aaroexxt/6.1820-NEPTUNE/Paper/resources/brainstorm.png

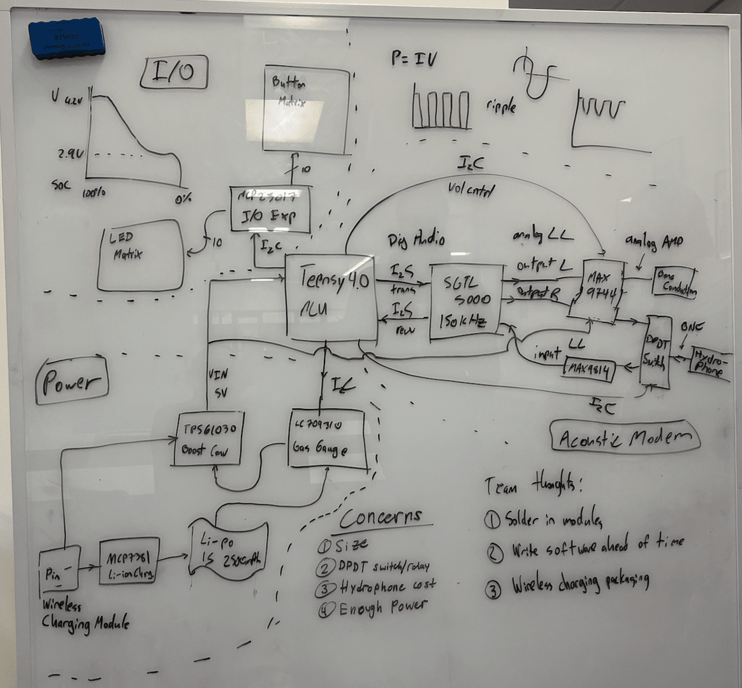
Paper/resources/brainstorm.png
