aaroexxt/6.1820-NEPTUNE/README.md

# 6.1820-NEPTUNE
6.1820 final project - Aaron Becker and Nora Bulovic
