aaroexxt/6.1820-NEPTUNE/Paper/NEPTUNE.tex

% !TEX encoding = UTF-8 Unicode
% !BIB TS-program = biber

% This file is NEPTUNE.tex, the LaTeX original source for Aaron Becker & Nora Bulovic's final project. It was based on MIT-Thesis.tex, a LaTeX template for formatting an MIT thesis with the mitthesis class.
%
% Version history:
% 0.1, 2025/3/14 - initial creation
% 0.2, 2025/3/19 - chapter organization
%
% Author: Aaron Becker & Nora Bulovic, copyright 2025. Released under the MIT license.
% Original template author: John H. Lienhard, copyright 2024. Reuse under the MIT license: https://ctan.org/license/mit 

% Documentation is here: https://ctan.org/pkg/mitthesis
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
  \newcolumntype{d}[1]{D{.}{.}{#1}}% use with dcolumn package. Note: dcolumns are set in math mode.
  % syntax: d{x.y} where x is max number of digits before decimal and y is max number after.
% Package for multipage table in Appendix B.
\usepackage{longtable}% typeset multi-page tables (https://ctan.org/pkg/longtable)
%\usepackage{tabularx}% adjustable-width columns in tabular (https://ctan.org/pkg/tabularx)
%% Package for improved typography
\usepackage{microtype}% typographic fine-tuning, used in sample thesis committee page, but also acting globally on the text 

%%%%%%%%%  Graphics path (to figure files)  %%%%%%%%%%%%%%%%%%%%%%%%%%%%%%%%
%% Can set graphicspath to point to specific directories containing figures (the current directory is searched automatically)
%% For instance, to search a subdirectory of the current directory called "figures" and a parallel directory called "art", set:
\graphicspath{ {resources}}
% \graphicspath{ {figures/} {../art/} }% For details see: https://latexref.xyz/dev/latex2e.html#g_t_005cgraphicspath

%%%%%%%%%  Representative set-up for biblatex  %%%%%%%%%%%%%%%%%%%%%%%%%%%%%

%% Numerical citations of references
\usepackage[style=ext-numeric-comp,giveninits=true,maxbibnames=10,sorting=none]{biblatex}

%% IEEE style citations and references
% \usepackage[style=ieee,maxbibnames=10,sorting=none]{biblatex}% style=ext-numeric-comp,articlein=false,giveninits=true
%	 \DefineBibliographyStrings{english}{url= \textsc{url} ,  }% replaces the IEEE default "[Online]. Available" by "URL"

%% author-year style citations and references 
%% use \parencite, not \cite, when you want "(Author, year)"
%% The sample files are not set up to include parentheses.
% \usepackage[style=authoryear, maxbibnames=10]{biblatex} 

\addbibresource{neptune-bibliography.bib}

%% to avoid split urls and stretched white space, you can set the bibliography ragged-right:
%\appto{\bibsetup}{\raggedright}

%% biblatex is very powerful, and you can customize most aspects the reference list and citations to suit your needs.
%%   documentation is here: https://ctan.org/pkg/biblatex
%%   cheat sheet is here:   https://tug.ctan.org/info/biblatex-cheatsheet/biblatex-cheatsheet.pdf

%% To ensure citations are set, run Latex --> biblatex/biber --> Latex again

%%%%%%%%%%%  Metadata  %%%%%%%%%%%%%%%%%%%%%%%%%%%%%%%%%%%%%%%%%%%%%%%%%%%%%%%

\hypersetup{%
	pdfsubject={NepTune: Inexpensive Underwater Node for Remote Sensing and Communication},
% 
	pdfkeywords={Massachusetts Institute of Technology, MIT, water, communication, ocean, radio frequency, RF, sensor node, underwater, Aaron Becker, Nora Bulovic},
	% Add keywords that will help search engines and libraries to find your work.
	% Includes the name[s] of the author[s] 
	% (If you used \DocumentMetadata at line 14, you can just put "\CopyrightAuthor," for the names.)
%
	pdfurl={},
	% If you have a url for the thesis, put it here. Otherwise delete this.
	% (MIT Libraries will put your thesis in DSPACE with a persistent url after you submit it.)
%	
	pdfcontactemail={aaron.becker@gmail.com},
	% You can put a [permanent] email address into the metadata, if you like.
	% Otherwise delete this.
%
	pdfauthortitle={},
	% If you have a title, you can include it here.
}

%%%%%%%%%%%%  Math operators %%%%%%%%%%%%%%%%%%%%%%%%%%%%%%%%%%%%%%%%%%%%%%%%%%%%

% These commands declare two math operators, \erf{..} and \erfc{..} using mathtools
% note: * form produces automatic delimiter scaling; optional argument sets size manually, e.g. [\bigg]
% See Table 1.1 in Chapter 1

\DeclareMathOperator{\Erf}{erf}
\DeclareMathOperator{\Erfc}{erfc}
\DeclarePairedDelimiterXPP\erf[1]{\Erf\mkern1mu}(){}{#1}% increase to 2mu with stix2 font
\DeclarePairedDelimiterXPP\erfc[1]{\Erfc\mkern1mu}(){}{#1}

%%%%%%%%%%%%%%  End preamble %%%%%%%%%%%%%%%%%%%%%%%%%%%%%%%%%%%%%%%%%%%%%%%%%%%%%%%%%%%%%%%%%%%%%
%%%%%%%%%%%%%%%%%%%%%%%%%%%%%%%%%%%%%%%%%%%%%%%%%%%%%%%%%%%%%%%%%%%%%%%%%%%%%%%%%%%%%%%%%%%%%%%%%%

\begin{document}
%%% edit the following commands to match your thesis %%%%%%%%%%

\title{NepTune: Inexpensive Underwater Node for Remote Sensing and Communication}

\Author{Aaron M. Becker}{Department of Mechanical Engineering}
\Author{Nora Bulovic}{Department of Computer Science}

% If there is more than one supervisor, use the \Supervisor command for each.
\Supervisor{Dr. Barbara Hughey}{Senior Lecturer}

% Usage: \DegreeDate{Month}{year}
% Valid degree months are February, May, June, or September
\DegreeDate{May}{2025}

% Date that final thesis is submitted to department
\ThesisDate{May 9, 2025}

%%%%%%  Choose whether to have a CREATIVE COMMONS License  %%%%%%%%%%%%%%%%%%%%%%%%%%%%%%%%%%%%%%
%
% If you are using a cc license, uncomment the following line and insert details of your cc license here.
%
\CClicense{CC BY-NC 4.0}{https://creativecommons.org/licenses/by-nc/4.0/}
%

%%%%%%%%%%%%%%%%%%%%%%%%%%%%%%%%%%%%%%%%%%%%%%%%%%%%%%%%%%%%%%%%%%%%%%%%%%%%%%%%%%%%%%%%%%%%%%%%%

%%% Make titlepage
\maketitle

%%% Frontmatter
 %%%%%%%%%%%%%%%%%%%%%%%%%%%%%%%%%%%

% This page is optional. Edit the file committee_members.tex 
%\include{committee_members}

% The abstract environment creates all the required headings and footers. 
% You only need to the text of the abstract in the file abstract.tex
\begin{abstract}
	\input{abstract.tex}% use \input rather than \include because we're inside an environment
\end{abstract}

\include{acknowledgments}

%\include{biography}% biography.tex (optional, see https://libraries.mit.edu/distinctive-collections/thesis-specs/#format)

%%% Table of contents and lists of stuff (delete unused lists, i.e., if no tables or figures) %%%%%

\tableofcontents
\listoffigures
\listoftables

%%% Chapters of thesis  %%%%%%%%%%%%%%%%%%%%%%%%%%%%%%%%%%%%%%%%%%%%%%%%%%%%%%%%%%%%%%%%%%%%%%%%%%%

%% If you want to use "double spacing", you should start here...

\include{chapter1}
%\include{chapter2}
% \include{chapter3}
% \include{chapter4}

%%% Appendicies of thesis  %%%%%%%%%%%%%%%%%%%%%%%%%%%%%%%%%%%%%%%%%%%%%%%%%%%%%%%%%%%%%%%%%%%%%%%%

\appendix
\include{appendixa}
\include{appendixb}

%%% Bibliography (biblatex)  %%%%%%%%%%%%%%%%%%%%%%%%%%%%%%%%%%%%%%%%%%%%%%%%%%%%%%%%%%%%%%%%%%%%%%

\defbibheading{bibintoc}{\chapter*{#1}\addcontentsline{toc}{backmatter}{\refname}} 
% this sets the title of contents name for bibliography to \refname (= References)
% change "backmatter" to "chapter" if you prefer a bold face entry in the table of contents

\printbibliography[title={\refname},heading=bibintoc]

% biblatex also supports chapter-by-chapter bibliography, https://tex.stackexchange.com/a/296502/119566
% see the biblatex manual, section 3.14.3

\end{document}
