aaroexxt/6.1820-NEPTUNE/Paper/resources/elecDiagram.png

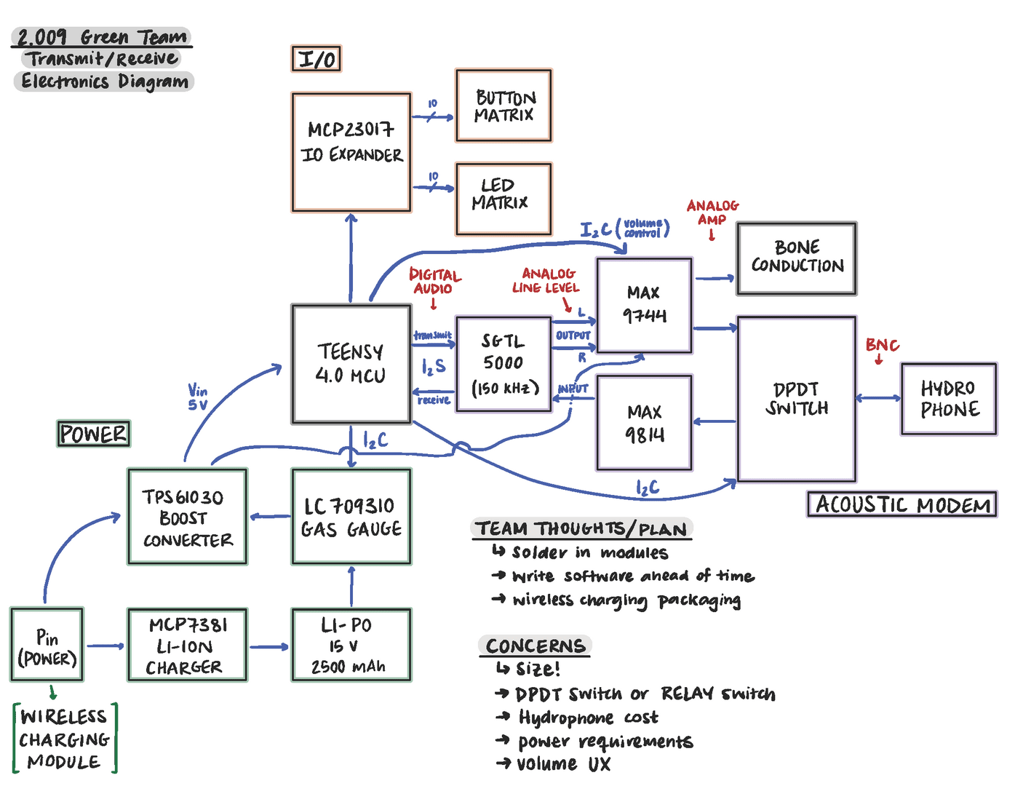
Paper/resources/elecDiagram.png
