aaroexxt/6.1820-NEPTUNE/Hardware - CAD/BottomCover.SLDPRT

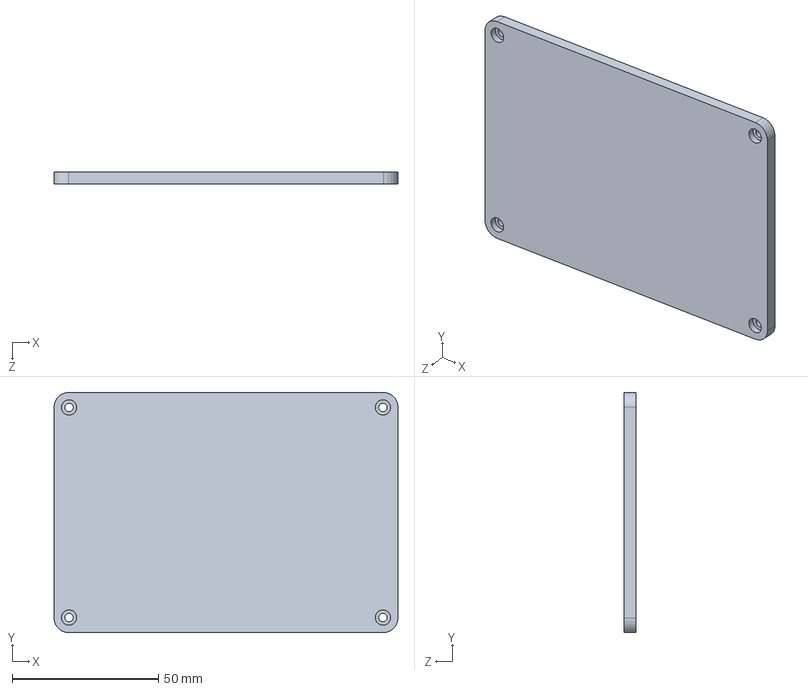
[picture p3: CAD file, 2025-05-01]
Hardware - CAD/BottomCover.SLDPRT
117.5 x 82.0 x 4.00 mm
