aaroexxt/6.1820-NEPTUNE/Hardware - Electronics/NeptuneV1/imports/Adafruit-MAX4466-SIMPLIFIED/Adafruit MAX4466 Mic Amp.dxf

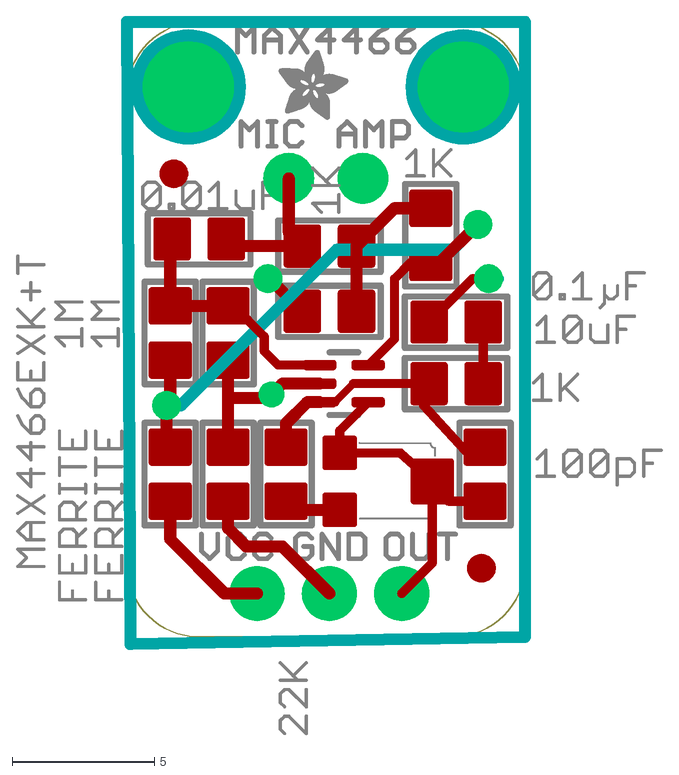
[picture p4: CAD file, 2025-04-03]
Hardware - Electronics/NeptuneV1/imports/Adafruit-MAX4466-SIMPLIFIED/Adafruit MAX4466 Mic Amp.dxf
22.7 x 25.2
