aaroexxt/6.1820-NEPTUNE/Hardware - Electronics/NeptuneV1/imports/Adafruit_BQ24074_Simplified.dxf

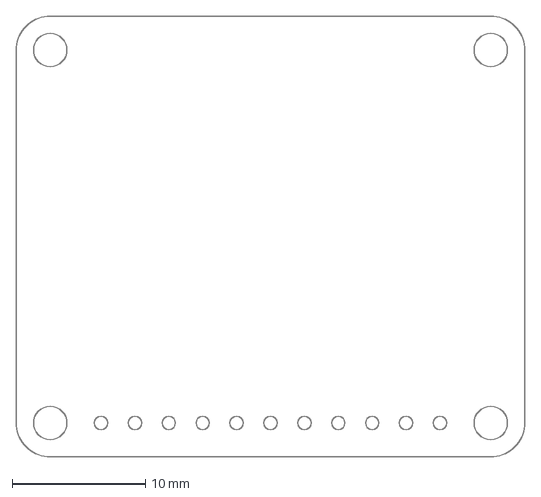
[picture p5: CAD file, 2025-04-03]
Hardware - Electronics/NeptuneV1/imports/Adafruit_BQ24074_Simplified.dxf
38.1 x 33.0 mm
