aaroexxt/6.1820-NEPTUNE/Hardware - CAD/TopCover.SLDPRT

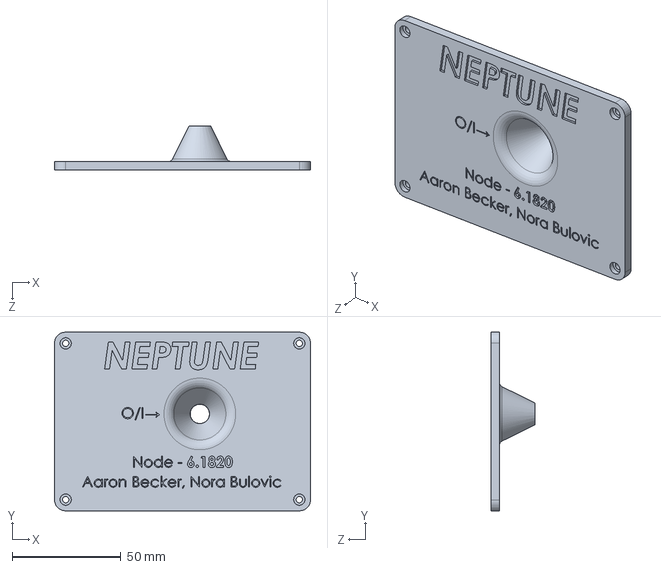
[picture p6: CAD file, 2025-05-01]
Hardware - CAD/TopCover.SLDPRT
117.5 x 82.0 x 20.3 mm
