aaroexxt/6.1820-NEPTUNE/Hardware - Electronics/NeptuneV1/imports/Adafruit_PB1K_Simplified.dxf

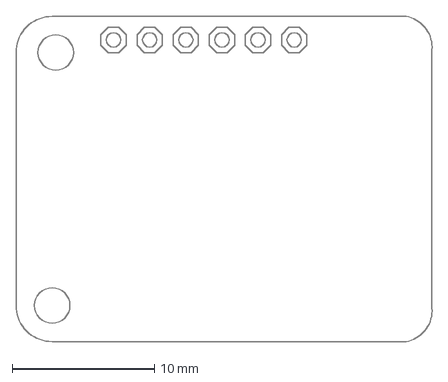
[picture p7: CAD file, 2025-04-03]
Hardware - Electronics/NeptuneV1/imports/Adafruit_PB1K_Simplified.dxf
29.2 x 22.9 mm
