aaroexxt/6.1820-NEPTUNE/Hardware - CAD/MiddlePlate.SLDPRT

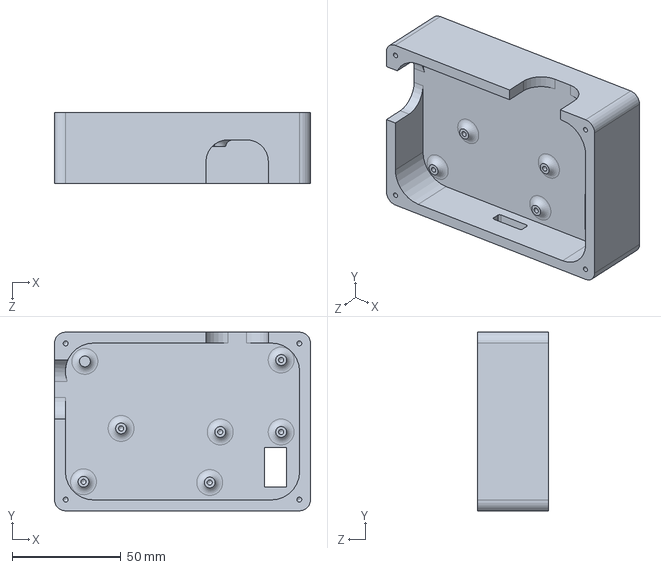
[picture p8: CAD file, 2025-04-18]
Hardware - CAD/MiddlePlate.SLDPRT
117.5 x 82.0 x 32.5 mm
