aaroexxt/6.1820-NEPTUNE/Hardware - Electronics/NeptuneV1/imports/Adafruit_TPA2016_Simplified.dxf

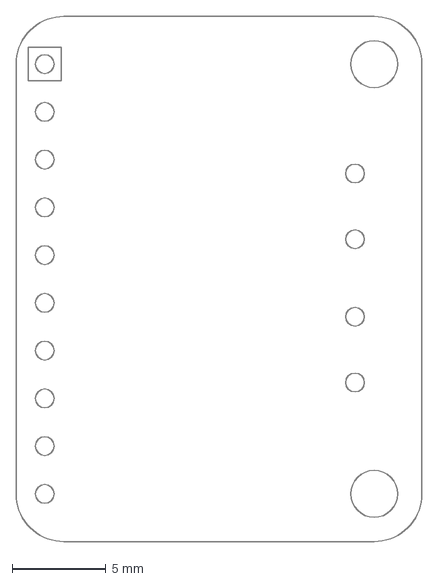
[picture p9: CAD file, 2025-04-03]
Hardware - Electronics/NeptuneV1/imports/Adafruit_TPA2016_Simplified.dxf
21.6 x 27.9 mm
