aaroexxt/6.1820-NEPTUNE/Hardware - Electronics/NeptuneV1/imports/Adafruit_MAX4466_Simplified.dxf

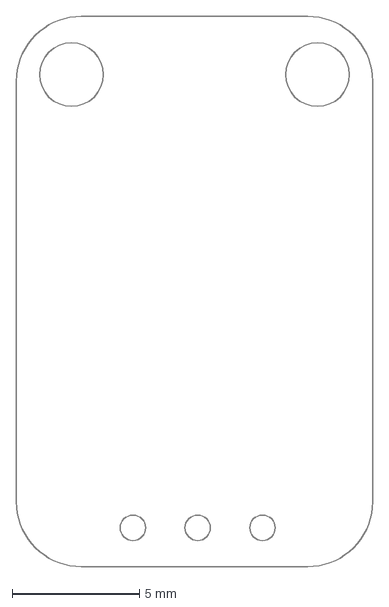
[picture p10: CAD file, 2025-04-03]
Hardware - Electronics/NeptuneV1/imports/Adafruit_MAX4466_Simplified.dxf
14.0 x 21.6 mm
