aaroexxt/6.1820-NEPTUNE/Hardware - CAD/EXT_258 1200mAh lipo.step

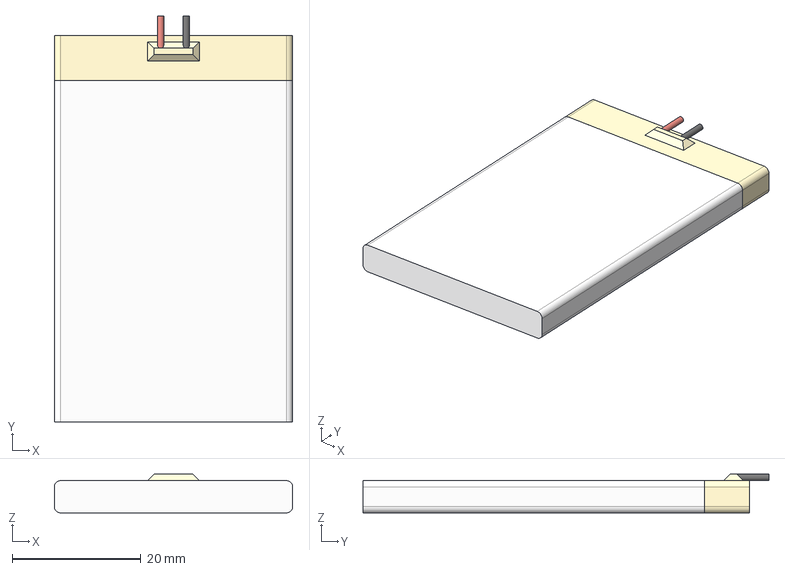
[picture p11: CAD file, 2025-04-10]
Hardware - CAD/EXT_258 1200mAh lipo.step
37.0 x 63.0 x 6.00 mm
