aaroexxt/6.1820-NEPTUNE/Hardware - CAD/EXT_94879A877_Off-White Nylon Phillips Rounded Head Screws.SLDPRT

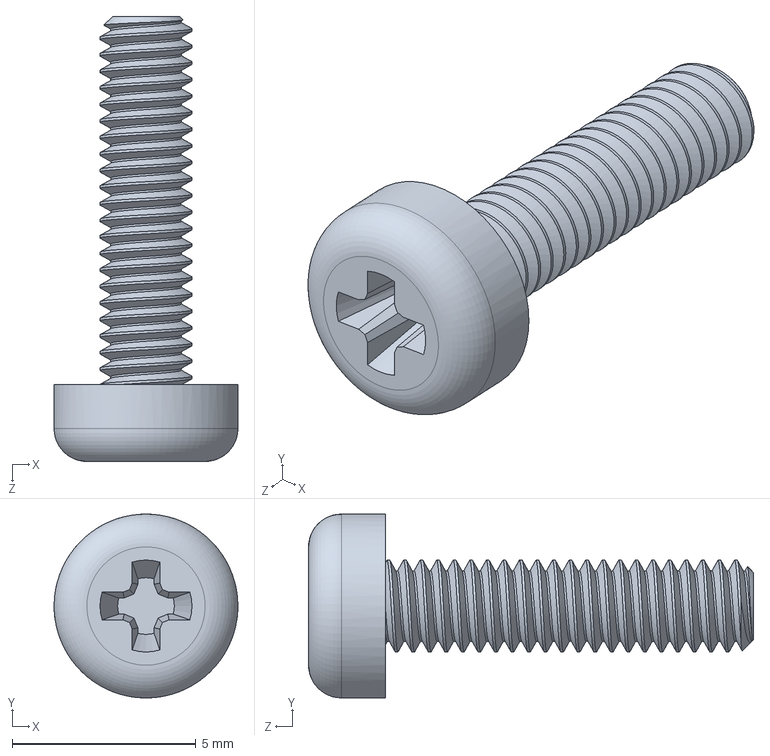
[picture p12: CAD file, 2025-04-18]
Hardware - CAD/EXT_94879A877_Off-White Nylon Phillips Rounded Head Screws.SLDPRT
5.00 x 5.00 x 12.1 mm
