aaroexxt/6.1820-NEPTUNE/(list of files, cad)

Other CAD files:
Hardware - CAD/BottomCover.STL
Hardware - CAD/EXT_258 1200mAh lipo.SLDPRT
Hardware - CAD/MiddlePlate.STL
Hardware - CAD/TopCover.STL
