aaroexxt/6.1820-NEPTUNE/Software - Embedded/test.txt

0.05 @ 4478.91Hz
0.08 @ 5986.23Hz
0.06 @ 4909.57Hz
0.08 @ 4909.57Hz
0.06 @ 5383.30Hz
0.05 @ 6029.30Hz
0.06 @ 5986.23Hz
0.06 @ 4608.10Hz
0.05 @ 4565.04Hz
0.06 @ 5383.30Hz
0.05 @ 4651.17Hz
0.06 @ 4565.04Hz
0.05 @ 5211.03Hz
0.05 @ 4478.91Hz
0.05 @ 5900.10Hz
0.06 @ 4521.97Hz
0.08 @ 4651.17Hz
0.05 @ 4651.17Hz
0.05 @ 5986.23Hz
0.05 @ 5857.03Hz
0.08 @ 5900.10Hz
0.04 @ 4866.50Hz
0.07 @ 4780.37Hz
0.05 @ 6718.36Hz
0.06 @ 4866.50Hz
0.05 @ 5986.23Hz
0.06 @ 5081.83Hz
0.09 @ 5986.23Hz
0.06 @ 4608.10Hz
0.08 @ 5555.57Hz
0.06 @ 4565.04Hz
0.06 @ 6029.30Hz
0.06 @ 4909.57Hz
0.06 @ 5340.23Hz
0.05 @ 5986.23Hz
0.06 @ 5081.83Hz
0.06 @ 4780.37Hz
0.07 @ 4866.50Hz
0.08 @ 6029.30Hz
0.05 @ 5124.90Hz
0.05 @ 7364.35Hz
0.05 @ 4737.30Hz
0.04 @ 4651.17Hz
0.08 @ 6029.30Hz
0.06 @ 5986.23Hz
0.08 @ 5986.23Hz
0.05 @ 5167.97Hz
0.06 @ 4565.04Hz
0.06 @ 4478.91Hz
0.05 @ 6761.42Hz
0.05 @ 4608.10Hz
0.05 @ 6029.30Hz
0.05 @ 6029.30Hz
0.06 @ 4651.17Hz
0.06 @ 5167.97Hz
0.06 @ 4823.44Hz
0.06 @ 4608.10Hz
0.05 @ 4608.10Hz
0.05 @ 4866.50Hz
0.06 @ 5038.77Hz
0.05 @ 4651.17Hz
0.05 @ 4737.30Hz
0.07 @ 5986.23Hz
0.06 @ 5986.23Hz
0.06 @ 4780.37Hz
0.06 @ 5426.37Hz
0.07 @ 5167.97Hz
0.06 @ 5986.23Hz
0.05 @ 5986.23Hz
0.04 @ 4780.37Hz
0.05 @ 7579.69Hz
0.07 @ 4478.91Hz
0.08 @ 6029.30Hz
0.05 @ 4608.10Hz
0.05 @ 5469.43Hz
0.05 @ 5124.90Hz
0.07 @ 5512.50Hz
0.07 @ 4823.44Hz
0.07 @ 5426.37Hz
0.05 @ 6287.69Hz
0.05 @ 5857.03Hz
0.05 @ 4737.30Hz
0.06 @ 4565.04Hz
0.05 @ 6158.50Hz
0.05 @ 5254.10Hz
0.06 @ 5986.23Hz
0.06 @ 5555.57Hz
0.06 @ 4823.44Hz
0.05 @ 5986.23Hz
0.06 @ 5900.10Hz
