aaroexxt/6.1820-NEPTUNE/Hardware - Electronics/hydrophoneSim.asc

C1: cap; 8nF
C3: cap; 8nF
R1: res; 35
R2: res; 35
V1: signal; PULSE(0 12 0 1n 1n 25u 50u 200)
V2: signal; PULSE(0 -12 0 1n 1n 25u 50u 200)
V3: signal; ""; AC 12
Named nets: 0, OUTPUT, V01, VO2
.tran 0.0005 startup
.ac dec 100 10k 100k
