aaroexxt/6.1820-NEPTUNE/Hardware - Electronics/hydrophoneSimAC.asc

C1: cap; {Cp}
L1: ind; {Ls}
R1: res; {Rp}
R2: res; {Rs}
V3: signal; ""; AC 1
Named nets: OUTPUT, 0, Vin
.ac dec 100 10k 100k
.param Rs=2.95
.param Ls=1.67e-04
.param Rp=155342
.param Cp=8.62e-09
.print ac mag(V(OUTPUT)/I(Vin)) phase(V(OUTPUT)/I(Vin))
