aaroexxt/6.1820-NEPTUNE/Hardware - Electronics/NeptuneV1/upperArm.kicad_sch

## KiCad design Hardware - Electronics/NeptuneV1/upperArm.kicad_sch (2025-04-03)

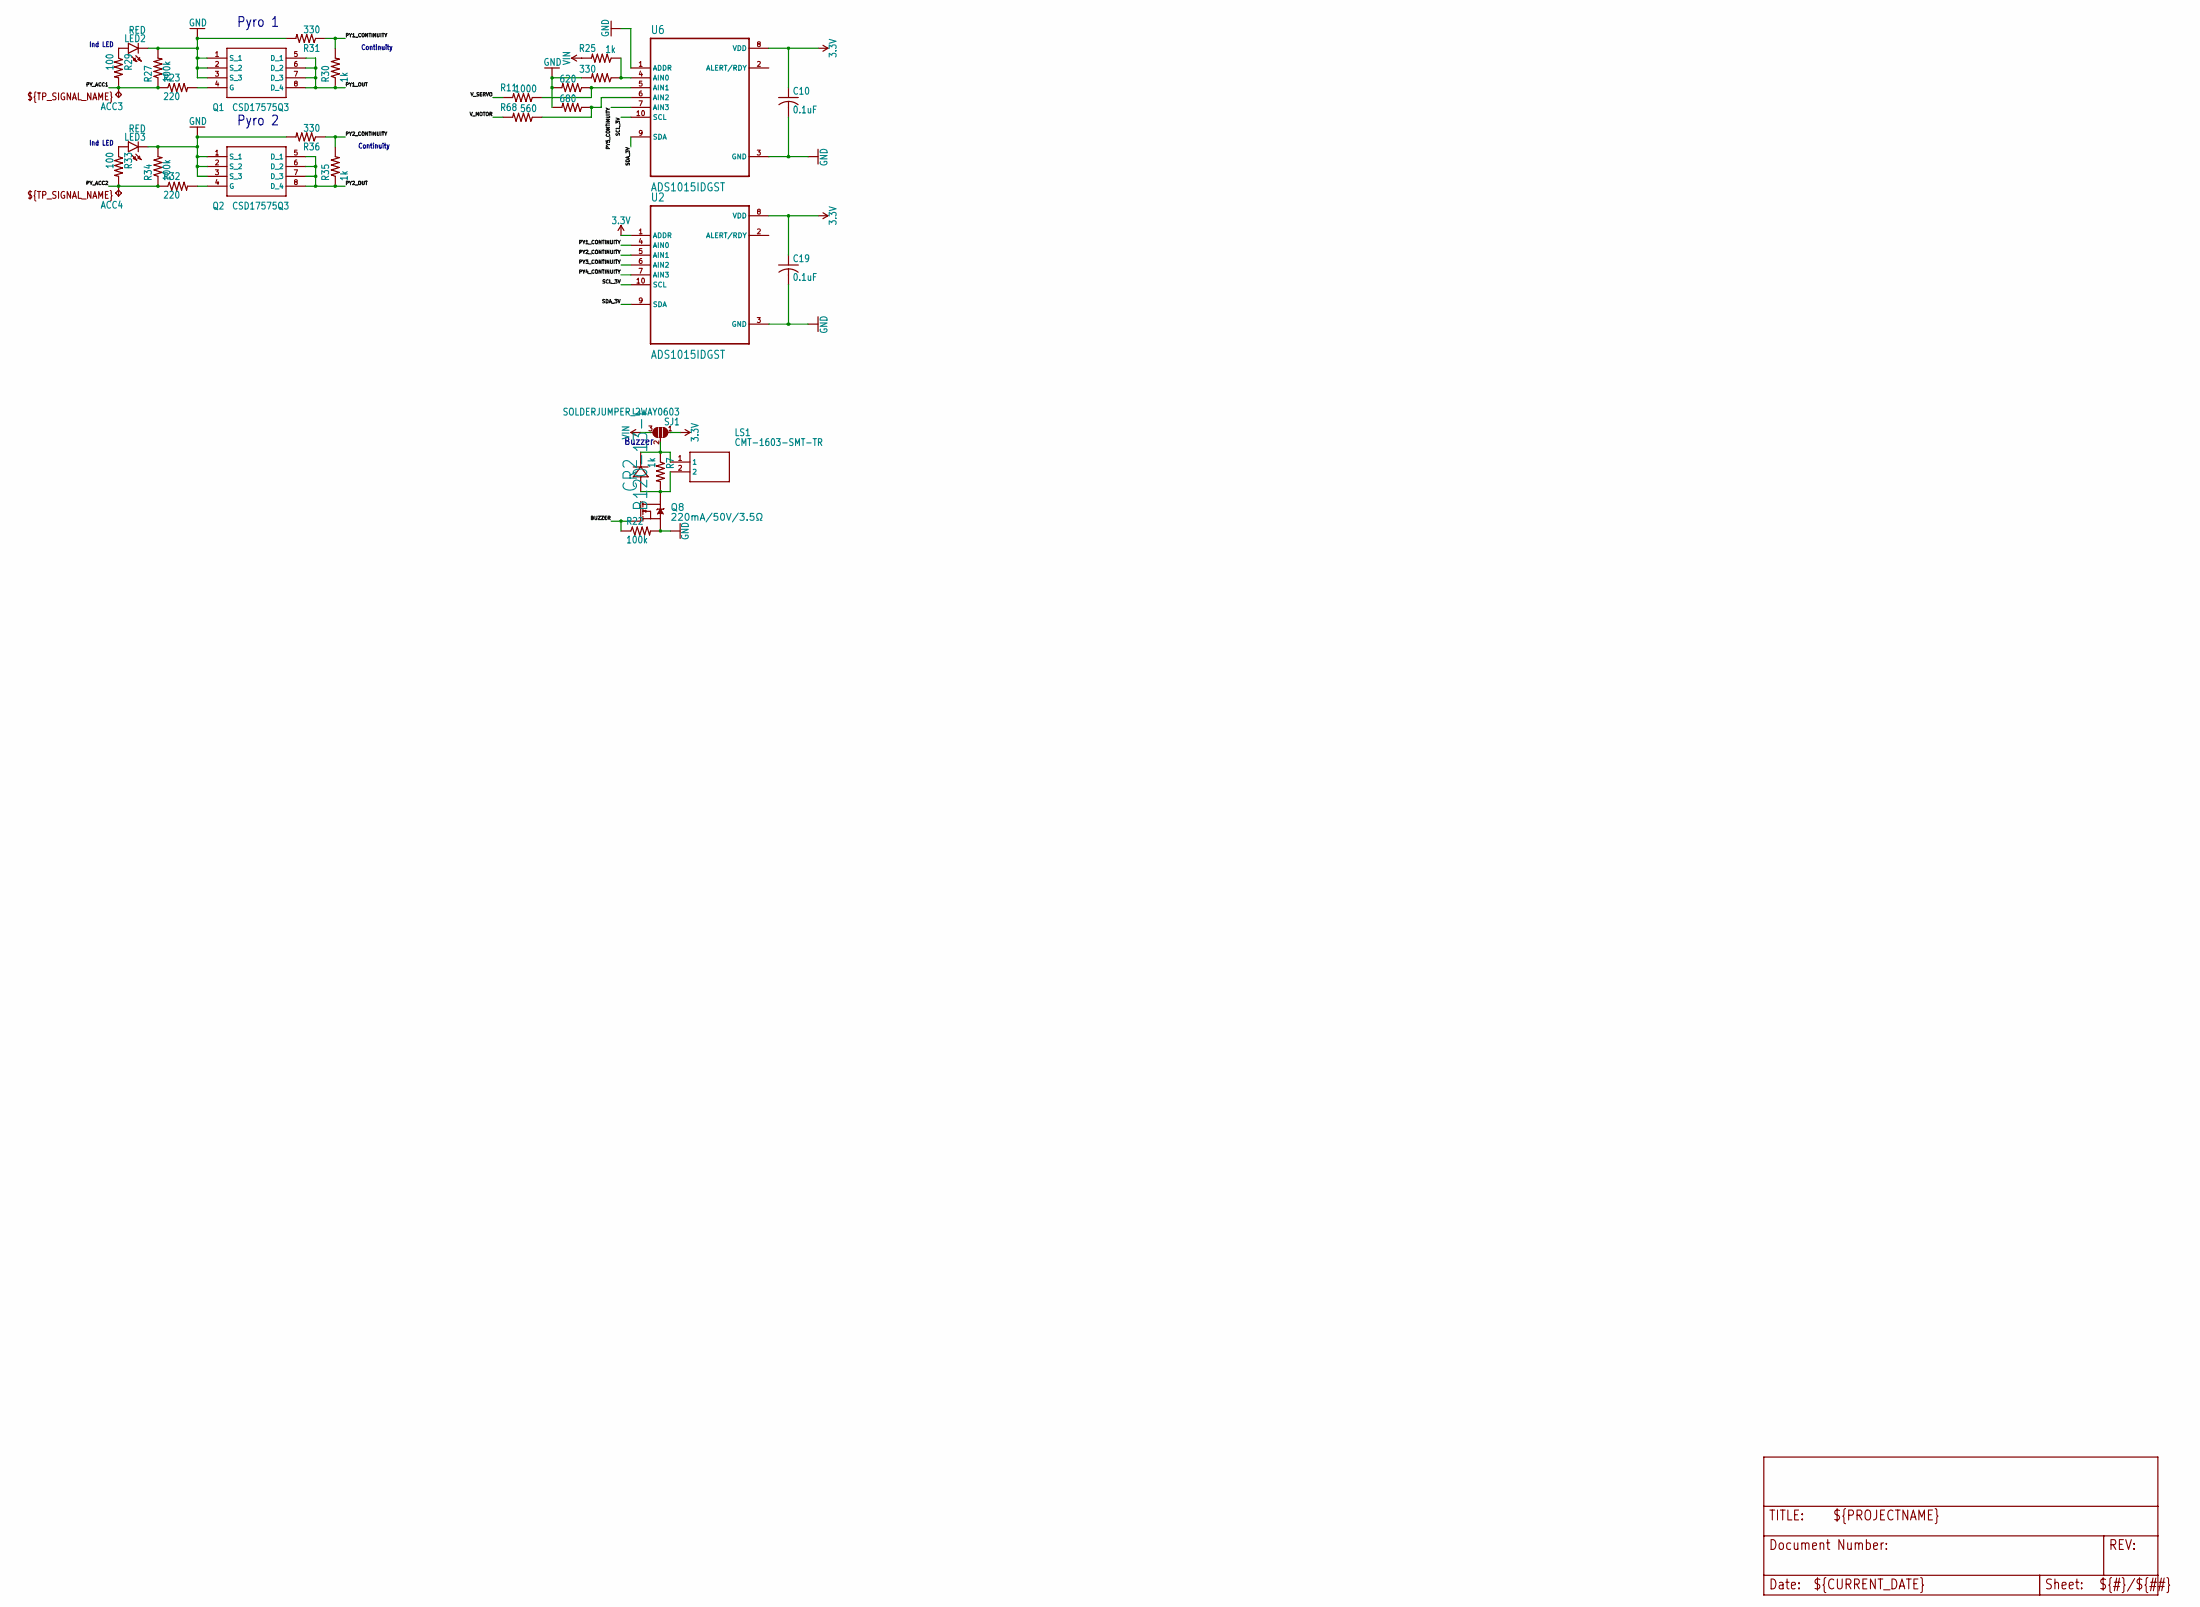
[picture p14: schematic upperArm.kicad_sch]

Parts:
ACC3, ACC4: TPB1,27; B1,27
C10, C19: 0.1uF; C0603
CR2: B120-13-F; SMA_DIO
LED2, LED3: RED; CHIP-LED0805
LS1: CMT-1603-SMT-TR; CMT1603SMTTR
Q1, Q2: CSD17575Q3; CSD16327
Q8: 220mA/50V/3.5Ω; SOT23-3
R7, R25, R30, R35: 1k; R0603
R10: 620; R0603
R11: 1000; R0603
R22, R27, R34: 100k; R0603
R23, R32: 220; R0603
R26, R31, R36: 330; R0603
R29, R33: 100; R0603
R67: 680; R0603
R68: 560; R0603
SJ1: SOLDERJUMPER_2WAY0603; SOLDERJUMPER_2WAY_OPEN_0603
U2, U6: ADS1015IDGST; SOP50P490X110-10N

Connections:
3.3V: C10.1, C19.1, SJ1.1, U2.1 (ADDR), U2.8 (VDD), U6.8 (VDD)
BUZZER: Q8.1 (G), R22.1
GND: C10.2, C19.2, LED2.C, LED3.C, Q1.1 (S_1), Q1.2 (S_2), Q1.3 (S_3), Q2.1 (S_1), Q2.2 (S_2), Q2.3 (S_3), Q8.2 (S), R10.2, R22.2, R26.2, R27.2, R31.2, R34.2, R36.2, R67.2, U2.3 (GND), U6.1 (ADDR), U6.3 (GND)
unnamed: CR2.1, LS1.1, R7.1, SJ1.2
unnamed: CR2.2, LS1.2, Q8.3 (D), R7.2
unnamed: LED2.A, R29.1
unnamed: LED3.A, R33.1
unnamed: Q1.4 (G), R23.2
unnamed: Q2.4 (G), R32.2
unnamed: R10.1, R11.1, U6.5 (AIN1)
unnamed: R25.1, R26.1, U6.4 (AIN0)
unnamed: R67.1, R68.1, U6.6 (AIN2)
PY1_CONTINUITY: R30.2, R31.1, U2.4 (AIN0)
PY1_OUT: Q1.5 (D_1), Q1.6 (D_2), Q1.7 (D_3), Q1.8 (D_4), R30.1
PY2_CONTINUITY: R35.2, R36.1, U2.5 (AIN1)
PY2_OUT: Q2.5 (D_1), Q2.6 (D_2), Q2.7 (D_3), Q2.8 (D_4), R35.1
PY3_CONTINUITY: U2.6 (AIN2)
PY4_CONTINUITY: U2.7 (AIN3)
PY5_CONTINUITY: U6.7 (AIN3)
PY_ACC1: ACC3.TP, R23.1, R27.1, R29.2
PY_ACC2: ACC4.TP, R32.1, R33.2, R34.1
SCL_3V: U2.10 (SCL), U6.10 (SCL)
SDA_3V: U2.9 (SDA), U6.9 (SDA)
VIN: R25.2, SJ1.3
V_MOTOR: R68.2
V_SERVO: R11.2

Notes on the sheet:
Ind LED
Pyro 2
Continuity
Buzzer
Pyro 1
