aaroexxt/6.1820-NEPTUNE/Hardware - Electronics/NeptuneV1/imports/Adafruit-BQ24074-SIMPLIFIED/Adafruit_BQ24074.sch

## EAGLE design Hardware - Electronics/NeptuneV1/imports/Adafruit-BQ24074-SIMPLIFIED/Adafruit_BQ24074.sch (2025-04-03)

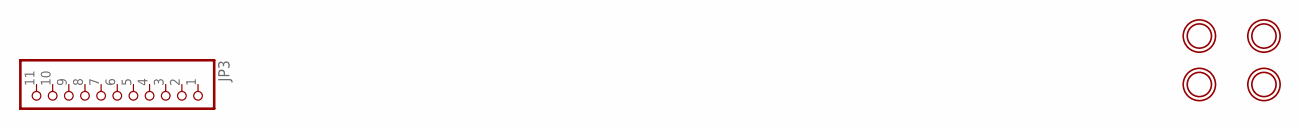
[picture p19: schematic Adafruit_BQ24074.sch]

Parts:
JP3: HEADER-1X1176MIL; 1X11_ROUND_76
U$3, U$4, U$11, U$12: MOUNTINGHOLE2.5; MOUNTINGHOLE_2.5_PLATED
