aaroexxt/6.1820-NEPTUNE/Hardware - Electronics/NeptuneV1/imports/Adafruit-MAX4466-SIMPLIFIED/Adafruit MAX4466 Mic Amp.sch

## EAGLE design Hardware - Electronics/NeptuneV1/imports/Adafruit-MAX4466-SIMPLIFIED/Adafruit MAX4466 Mic Amp.sch (2025-04-03)

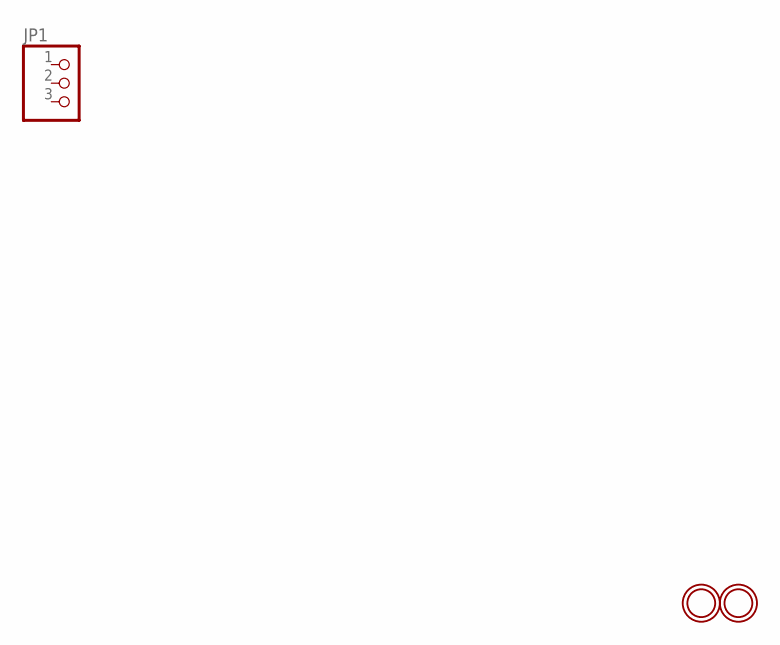
[picture p20: schematic Adafruit MAX4466 Mic Amp.sch]

Parts:
JP1: HEADER-1X376MIL; 1X03_ROUND_76
U$11, U$14: MOUNTINGHOLE2.5; MOUNTINGHOLE_2.5_PLATED
