aaroexxt/6.1820-NEPTUNE/Hardware - Electronics/NeptuneV1/imports/Adafruit-PowerBoost-SIMPLIFIED/Adafruit PowerBoost 1000 Basic.sch

## EAGLE design Hardware - Electronics/NeptuneV1/imports/Adafruit-PowerBoost-SIMPLIFIED/Adafruit PowerBoost 1000 Basic.sch (2025-04-03)

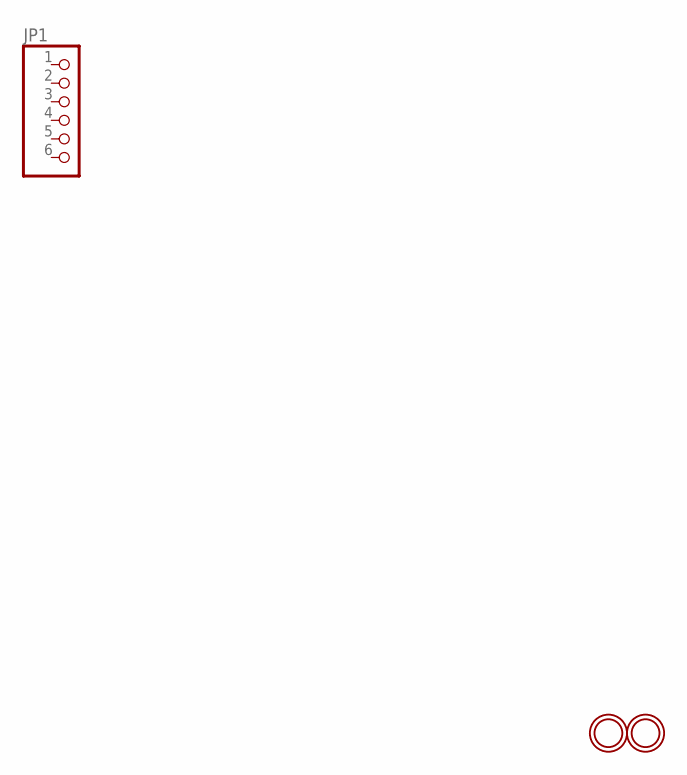
[picture p21: schematic Adafruit PowerBoost 1000 Basic.sch]

Parts:
JP1: PINHD-1X6CB; 1X06-CLEANBIG
U$10, U$11: MOUNTINGHOLE2.5; MOUNTINGHOLE_2.5_PLATED
