aaroexxt/6.1820-NEPTUNE/Hardware - Electronics/NeptuneV1/imports/Adafruit-TPA2016-SIMPLIFIED/Adafruit TPA2016D2.sch

## EAGLE design Hardware - Electronics/NeptuneV1/imports/Adafruit-TPA2016-SIMPLIFIED/Adafruit TPA2016D2.sch (2025-04-03)

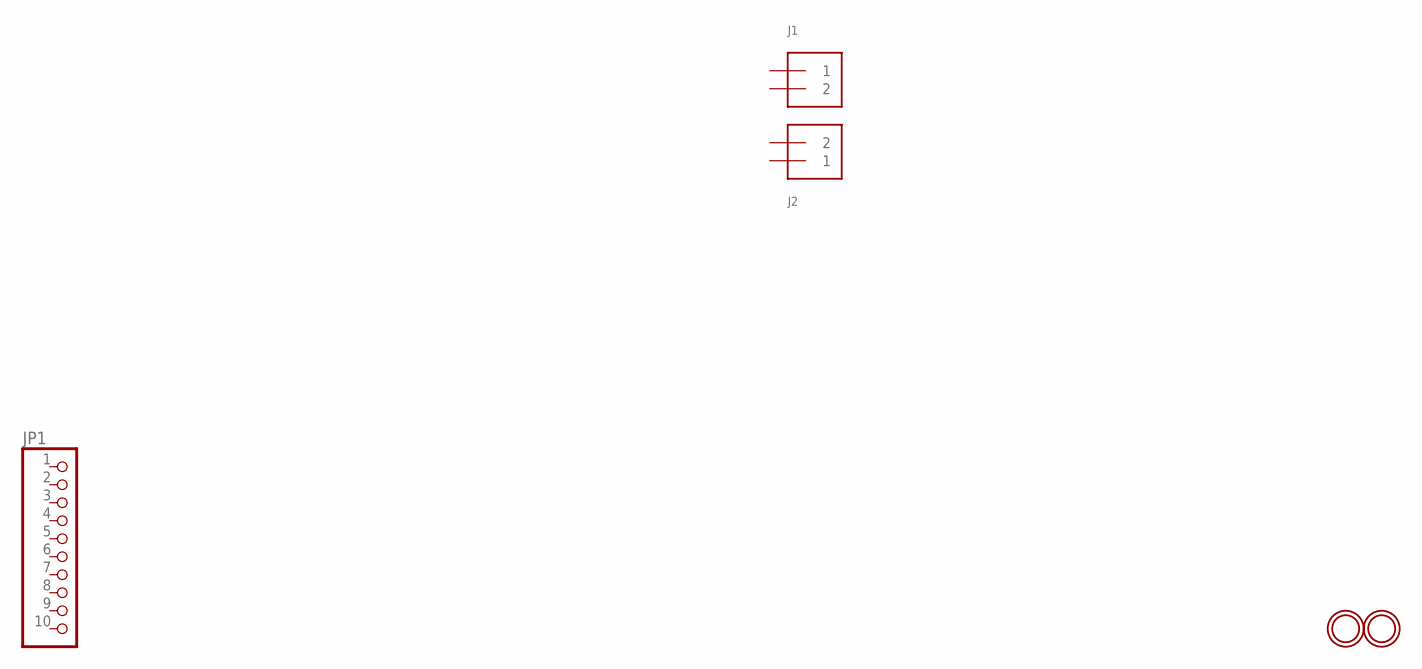
[picture p22: schematic Adafruit TPA2016D2.sch]

Parts:
J1, J2: TERMBLOCK_1X2; TERMBLOCK_1X2-3.5MM
JP1: HEADER-1X1070MIL; 1X10_ROUND70
U$20, U$21: MOUNTINGHOLE2.5_THICK; MOUNTINGHOLE_2.5_PLATED_THICK
