aaroexxt/6.1820-NEPTUNE/Hardware - Electronics/NeptuneV1/upperArm.brd

## EAGLE design Hardware - Electronics/NeptuneV1/upperArm.brd (2025-04-03)





Parts:
3V, 5V, 5VG: TPB1,27; B1,27
BQ_USB_VBUS: TPB1,27; B1,27
C1, C4, C6, C12, C13, C14, C15, C18, C19, C20, C22, C23, C24, C25, C26, C28: 1uF; C0805
C2, C3, C27, C29: 10uF; C0805
C5, C11, C21: 0.1uF; C0805
C7: 0.1µF; 0805
C8: 0.01uF; 0805
C9: 100pF; 0805
C10: 10uF; 0805
C16, C17: 9pF; C0805
D1, D2, D3, D4, D5, D6, D7, D8, D9, D10, D11, D13: WS2812_5050; WS2812-5X5-4PIN
D12: SK34AQ-LTP; DIOM5226X244N
FB2, FB3: BLM18PG471SN1D; BLM18SP221SN1B
HYD_COM1, HYD_COM2: TPB1,27; B1,27
HYD_RX_AMP: TPB1,27; B1,27
HYD_TX_SIG: TPB1,27; B1,27
IC1: LTC4311CSC6#TRPBF; SOT65P210X100-6N
IC2: MAX17048G+T10; SON50P200X200X80-9N
IC3: PAM8904EGPR; QFN40P200X200X80-13N
IC4: DS04-254-2-02BK-SMT; DS04254202BKSMT
J2, J3, J4: 1727052
JP1: PINHD-1X11; 1X11
JP2, JP3, JP8, JP14: JUMPER-SMT_3_1-NC_TRACE_NO-SILK; SMT-JUMPER_3_1-NC_TRACE_NO-SILK
JP4: PINHD-1X6; 1X06
JP5, JP6: JUMPER-SMT_2_NC_TRACE_NO-SILK; SMT-JUMPER_2_NC_TRACE_NO-SILK
JP7, JP11, JP12, JP13: PINHD-1X1; 1X01
K1, K2: G6K-2P-Y-DC5; G6K2PYDC12
LED2: RED; CHIP-LED0805
Q1, Q2: CSD17575Q3; CSD16327
Q3, Q4: BSS138; SOT23-WIDE
R1, R2, R3, R4, R5, R17, R18, R32: 10k; R0805
R6, R7, R8: 1K; 0805
R9, R10: 1M; 0805
R11: 22K; 0805
R12: 3386P-1-104LF; POT_3386P
R13: 100; R0603
R14, R23: 220; R0805
R27: 100k; R0805
R29: 100; R0805
S1: GPTS203211B
SCLG: TPB1,27; B1,27
SCL_3V, SCL_5V: TPB1,27; B1,27
SDAG: TPB1,27; B1,27
SDA_3V, SDA_5V: TPB1,27; B1,27
TPA_L+: TPB1,27; B1,27
TPA_L-: TPB1,27; B1,27
TPA_R+: TPB1,27; B1,27
TPA_R-: TPB1,27; B1,27
TP_TXRX: TPB1,27; B1,27
U1: MAX4466EXK+T; SC70-5
U8: BNO055; LGA28R50P4X10_380X520X100
U$1: AUDIOSHIELD
U$7: PINHD-1X10; 1X10
U$11, U$14, U$15, U$16, U$17, U$18, U$19: MOUNTINGHOLE2.5; MOUNTINGHOLE_2.5_PLATED
VBAT, VBAT1: TPB1,27; B1,27
VR1: 3310P-125-103L; 3310P125103L
Y1: NDK_NX3215SA-32.768K-STD-MUA-9; NDK_NX3215SA-32.768K-STD-MUA-8_0

Connections:
3.3V: 3V.TP, C5.1, C28.2, C29.2, J2.2, JP8.1, JP14.3, Q3.1 (G), Q4.1 (G), R2.2, R3.2, R32.2, U8.3 (VDD), U8.28 (VDDIO), U$1.3V, U$7.10, VR1.1 (CCW)
3.3VI2C_SCL0: JP3.3, U$1.19
3.3VI2C_SCL1: JP3.1, U$1.16
3.3VI2C_SDA0: JP2.3, U$1.18
3.3VI2C_SDA1: JP2.1, U$1.17
5V: 5V.TP, C3.1, C12.2, C13.2, C14.2, C15.2, C18.2, C19.2, C20.2, C22.2, C23.2, C24.2, C25.2, C26.2, C27.2, D1.VCC, D2.VCC, D3.VCC, D4.VCC, D5.VCC, D6.VCC, D7.VCC, D8.VCC, D9.VCC, D10.VCC, D11.VCC, D13.VCC, IC1.1 (VCC), IC3.12 (VIN), IC4.3 (NO_2), IC4.4 (NO_1), J3.2, JP4.1, JP14.1, K1.1 (+), K2.1 (+), R1.2, R17.2, R18.2, U$1.5V, U$7.1
AGND: C7.2, C10.2, FB2.1, K2.2 (NC_1), R9.1, U1.2 (GND)
AVCC: FB3.1, R7.2, R10.2, U1.5 (VCC)
BONECOND_+: J2.5, JP7.1, TPA_L+.TP
BONECOND_-: J2.6, JP11.1, TPA_L-.TP
BQ_CE: JP1.5
BQ_CHG: JP1.7
BQ_ISET: JP1.4
BQ_LOAD_OUT: JP1.8, JP4.6
BQ_PGOOD: JP1.6
BQ_THERM: JP1.3
BQ_USB_VBUS: BQ_USB_VBUS.TP, D12.1 (K), JP1.1
GND: 5VG.TP, C1.2, C2.2, C3.2, C5.2, C11.2, C12.1, C13.1, C14.1, C15.1, C16.1, C17.1, C18.1, C19.1, C20.1, C21.1, C22.1, C23.1, C24.1, C25.1, C26.1, C27.1, C28.1, C29.1, D1.GND, D2.GND, D3.GND, D4.GND, D5.GND, D6.GND, D7.GND, D8.GND, D9.GND, D10.GND, D11.GND, D13.GND, FB2.2, IC1.2 (GND_1), IC1.5 (GND_2), IC2.1 (CTG), IC2.4 (GND), IC2.6 (QSTRT), IC2.9 (EP), IC3.5 (GND), IC3.13 (EP), J3.1, J3.6, J4.2, J4.4, J4.6, JP1.2, JP1.9, JP1.11, JP4.2, JP4.5, JP5.1, JP6.1, LED2.C, Q1.1 (S_1), Q1.2 (S_2), Q1.3 (S_3), Q2.1 (S_1), Q2.2 (S_2), Q2.3 (S_3), R4.1, R5.2, R27.2, S1.1, SCLG.TP, SDAG.TP, U8.2 (GND), U8.5 (PS1), U8.6 (PS0), U8.10 (PIN10), U8.15 (PIN15), U8.16 (PIN16), U8.17 (COM3), U8.18 (COM2), U8.25 (GNDIO), U$1.G, U$1.GND, U$1.GND_MIC (MIC_GND), U$1.INGND1, U$1.INGND2, U$1.OUTGND, U$7.2, VBAT1.TP, VR1.3 (CW)
HYD_COM1: HYD_COM1.TP, J2.3, K1.3 (COM_1)
HYD_COM2: HYD_COM2.TP, J2.4, K2.3 (COM_1)
HYD_RX_IN1: C8.1, K1.2 (NC_1), R6.1
HYD_RX_INPUT: C9.1, HYD_RX_AMP.TP, R12.1, R12.2, U1.4 (OUT), U$1.MIC
HYD_TX_OUT1: IC3.6 (VO2), K1.4 (NO_1)
HYD_TX_OUT2: IC3.7 (VO1), K2.4 (NO_1)
HYD_TX_SIG: HYD_TX_SIG.TP, IC3.3 (DIN), U$1.3
IMU_CLK1: C16.2, U8.27 (XIN32), Y1.1
IMU_CLK2: C17.2, U8.26 (XOUT32), Y1.2
LED_BRIDGE: D6.DI, D8.DO
LED_DIN: R13.1, U$1.2
LED_DOUT: D11.DO, J3.5
unnamed: IC1.3 (ENABLE), R1.1
unnamed: JP12.1, TPA_R+.TP
unnamed: JP13.1, TPA_R-.TP
unnamed: D6.DO, D7.DI
unnamed: IC2.3 (VDD), JP8.2
unnamed: Q2.4 (G), R14.2
unnamed: C2.1, IC3.10 (VOUT)
unnamed: D13.DI, R13.2
unnamed: JP5.2, U$7.4
unnamed: D1.DO, D2.DI
unnamed: IC3.1 (EN1), IC4.2 (COM_2), R4.2
unnamed: IC3.2 (EN2), IC4.1 (COM_1), R5.1
unnamed: FB3.2, JP14.2
unnamed: C7.1, R6.2, R7.1
unnamed: C8.2, R9.2, R10.1, U1.1 (IN+)
unnamed: D1.DI, D13.DO
unnamed: C9.2, R8.2, R11.1, U1.3 (IN-)
unnamed: C10.1, R8.1
unnamed: R11.2, R12.3
unnamed: D12.2 (A), J4.3
unnamed: D2.DO, D3.DI
unnamed: D3.DO, D4.DI
unnamed: D4.DO, D5.DI
unnamed: D5.DO, D8.DI
unnamed: D7.DO, D9.DI
unnamed: D9.DO, D10.DI
unnamed: D10.DO, D11.DI
unnamed: JP6.2, U$7.7
unnamed: C21.2, U8.9 (CAP)
unnamed: R32.1, U8.4 (NBOOT_LOAD_PIN)
unnamed: Q1.4 (G), R23.2
unnamed: LED2.A, R29.1
NC_BCLK: U$1.21
NC_DIN: U$1.7
NC_DOUT: U$1.8
NC_LRCLK: U$1.20
NC_MCLK: U$1.23
NC_MEMCS: U$1.6
NC_MISO: U$1.12
NC_MOSI: U$1.11
NC_SCK: U$1.13
NC_SDCS: U$1.10
NC_VOL: U$1.15
PAM_CN1: C4.2, IC3.4 (CN1)
PAM_CN2: C6.2, IC3.8 (CN2)
PAM_CP1: C4.1, IC3.9 (CP1)
PAM_CP2: C6.1, IC3.11 (CP2)
PB1K_EN: J4.5, JP4.4, S1.2
PB1K_LB: JP4.3
SCL_3V: IC2.7 (SCL), JP3.2, Q4.2 (S), R3.1, SCL_3V.TP, U8.19 (COM1), U$7.8
SCL_5V: IC1.6 (BUS1), J3.4, Q4.3 (D), R18.1, SCL_5V.TP
SDA_3V: IC2.8 (SDA), JP2.2, Q3.2 (S), R2.1, SDA_3V.TP, U8.20 (COM0), U$7.9
SDA_5V: IC1.4 (BUS2), J3.3, Q3.3 (D), R17.1, SDA_5V.TP
TPA_L+: U$1.OUTL, U$7.6
TPA_R+: U$1.OUTR, U$7.5
TPA_SHDN: U$7.3
TXRX_OUT1: K1.8 (-), Q1.5 (D_1), Q1.6 (D_2), Q1.7 (D_3), Q1.8 (D_4)
TXRX_OUT2: K2.8 (-), Q2.5 (D_1), Q2.6 (D_2), Q2.7 (D_3), Q2.8 (D_4)
TXRX_RELAY: R14.1, R23.1, R27.1, R29.2, TP_TXRX.TP, U$1.4
VBAT: C1.1, C11.1, IC2.2 (CELL), J4.1, JP1.10, JP8.3, VBAT.TP
VOL_POT_SIG: J2.1, U$1.14, VR1.2 (WIPER)

Notes on the sheet:
I2C Level Shifting
Abs Orientation (Gyro, Accel, Mag) and Temp
I2C Selector Logic (normal/alternate pins)
LTC4311 Active Terminator
Wireless Charger
On/Off Button
Questions for DR: - what to do with low battery outputs (from BQ, MAX, boost)? - transistor on input of PAM? 0.5x VIN from datasheet - extended length header pins through teensy audio shield - noise immunity by doubling up relays? should double up relays - soldered pads or screw terminals? - pinout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
LiPo Input
Gain =
VR1+R7
= ~25-125x gain
Low pass F3db = 1/R5*C4*2pi
nFet Relay Drive
Ind LED
TXRX Relay
Ferrite bead filtering
TXRX Relay 2

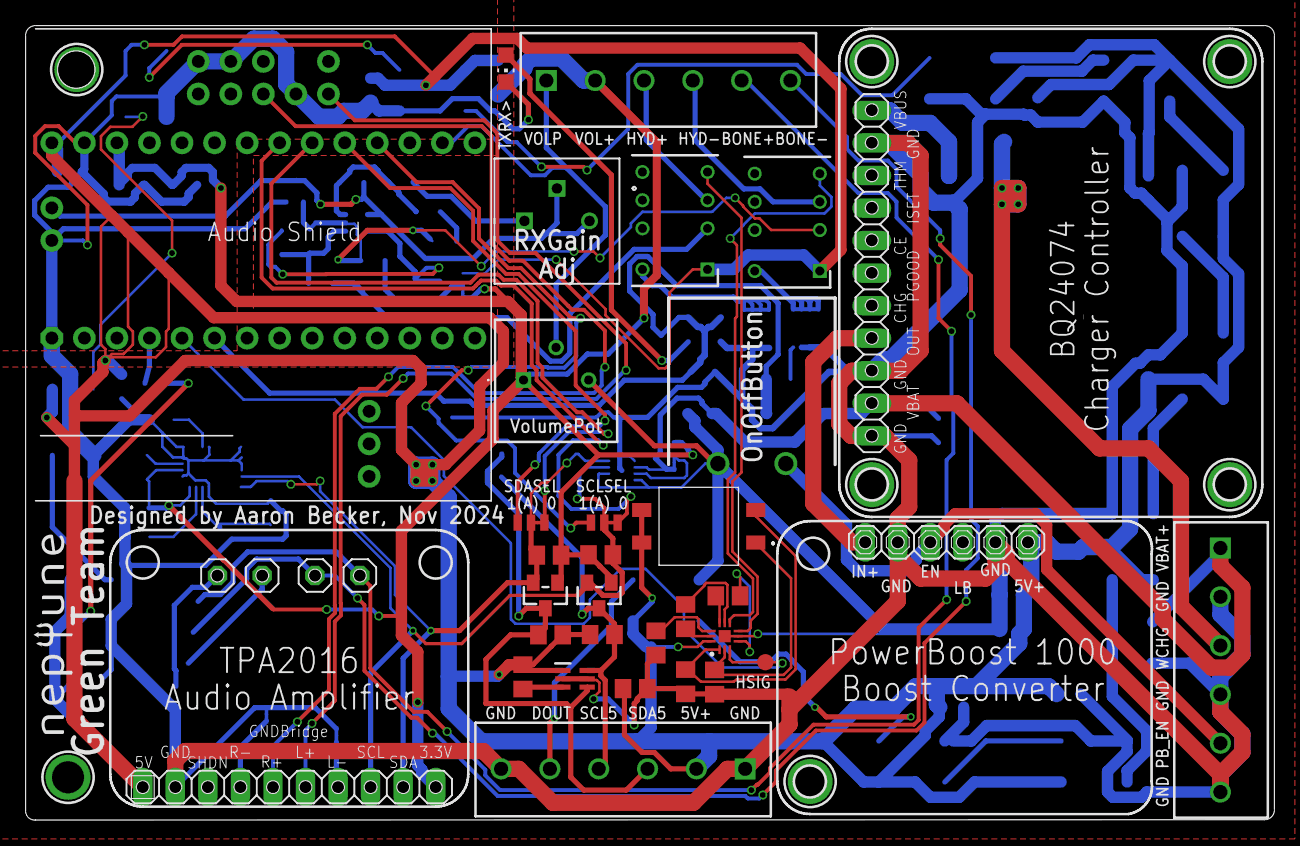
[picture p23: board upperArm.brd from above]

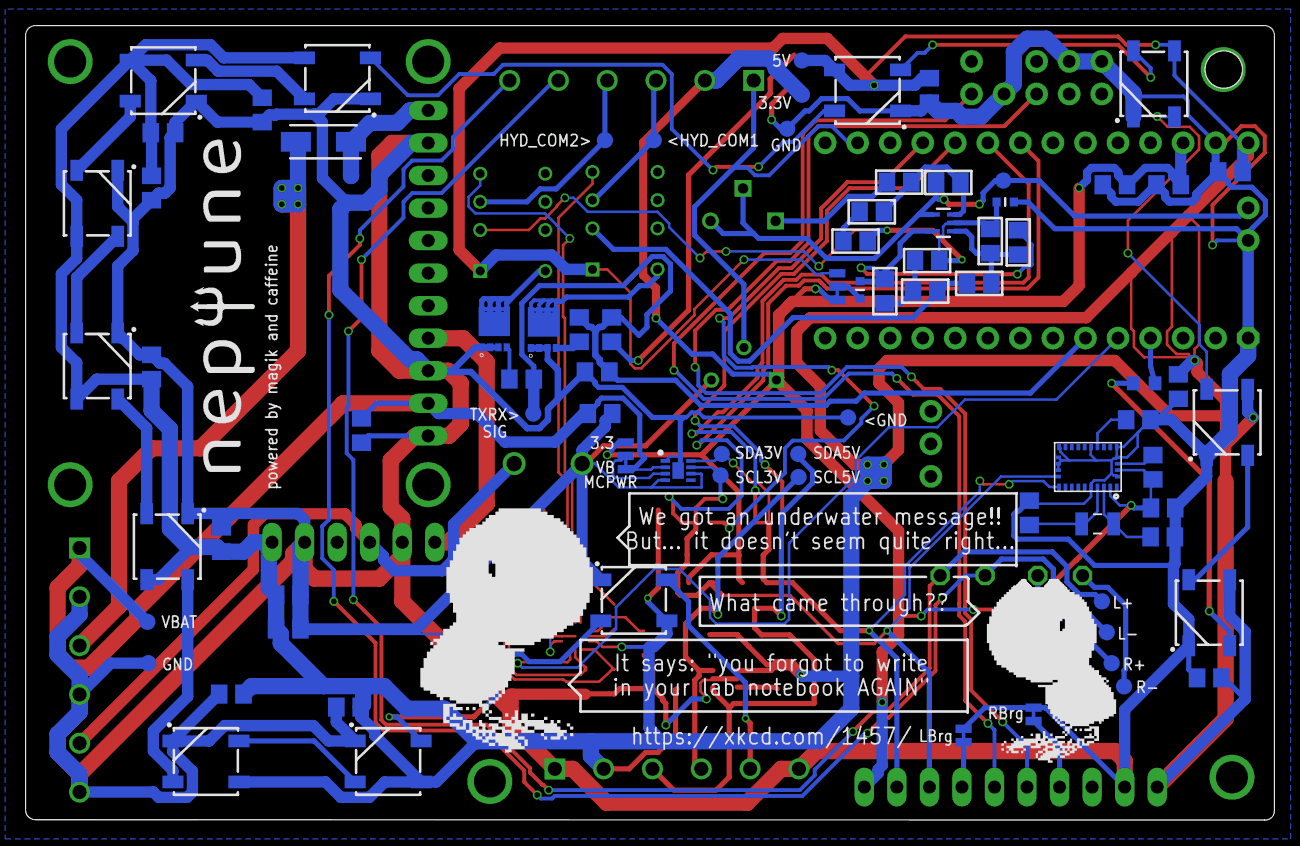
[picture p24: board upperArm.brd from below]

Board: 2 copper layers, 97.5 x 62.0 mm, 125 parts (82 on the bottom side), 73 nets.
