aaroexxt/6.1820-NEPTUNE/Software - Embedded/TestBandpassFiltering/pindefs.h

#ifndef PINDEFS_H
#define PINDEFS_H

    // Pin connected to neopixels strip
    // THESE ARE PINS ON THE TEENSY
    #define LED_PIN  2
    #define LED_COUNT 20
    int LED_BRIGHTNESS = 100;

    // Hydrophone output pin
    #define HYDROPHONE_PIN 3 // Which pin is the output?
    
    // TXRX Relay pin
    #define RELAY_PIN 4

    // Current ID (the ID the node listens to)
    #define NODE_ID 1
#endif
