aaroexxt/6.1820-NEPTUNE/(commit log)

2025-04-03 all PCBs and old software!
    [Adafruit MAX4466 Mic Amp.brd, Adafruit MAX4466 Mic Amp.dxf, Adafruit MAX4466 Mic Amp.sch, Adafruit PowerBoost 1000 Basic.brd, Adafruit PowerBoost 1000 Basic.sch, Adafruit TPA2016D2.brd, Adafruit TPA2016D2.sch, Adafruit_BQ24074.brd]
2025-04-10 paper started, code semi updated, solid modelling
    [BottomCover.SLDPRT, EXT_258 1200mAh lipo.SLDPRT, EXT_258 1200mAh lipo.step, MiddlePlate.SLDPRT, TopCover.SLDPRT]
2025-04-11 CAD and protocol description
    [BottomCover.STL, MiddlePlate.SLDPRT, MiddlePlate.STL, TopCover.STL]
2025-04-12 SECDED update (single error correction, double error detection)
    [UnderwaterMessage.h]
2025-04-12 aaaand bugfixes done! all scripts ready
    [NEPTUNE-Node.ino, TestBandpassFiltering.ino, TestFFTLiveSpectrogram.ino, TestFFTSweep.ino]
2025-04-18 box v2 updates!
    [BottomCover.SLDPRT, EXT_94879A875_Off-White Nylon Phillips Rounded Head Screws.SLDPRT, EXT_94879A877_Off-White Nylon Phillips Rounded Head Screws.SLDPRT, MiddlePlate.SLDPRT, TopCover.SLDPRT]
2025-05-01 CAD updates final (cover, counterbores)
    [BottomCover.SLDPRT, TopCover.SLDPRT]
2025-05-07 fixes from more testing
    [FreqThreshold.h, NEPTUNE-Node.ino, Protocol.h]
2025-05-08 BP filtering to bit counter mode
