aaroexxt/6.1820-NEPTUNE/(notices)

Notices in the files:
Paper/NEPTUNE.tex:
pdfcopyright="Copyright © 2025 by Aaron Becker and Nora Bulovic. All rights reserved."
parts and their libraries:
microbuilder: This work is placed in the public domain, and may be freely used for commercial and non-commercial work with the following conditions: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
SparkFun-Jumpers: Licensing: Creative Commons ShareAlike 4.0 International - https://creativecommons.org/licenses/by-sa/4.0
